saeed97/balancebelt/images/otherdata/schematics.jpg

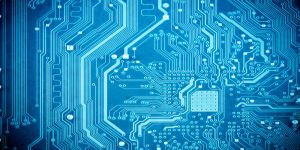
images/otherdata/schematics.jpg
