saeed97/balancebelt/images/about/about.png

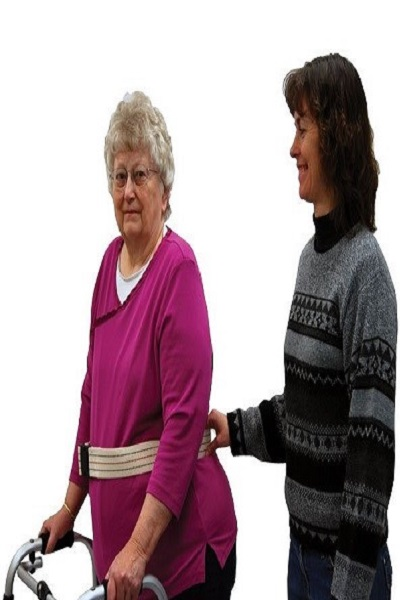
images/about/about.png
