saeed97/balancebelt/images/otherdata/data.jpg

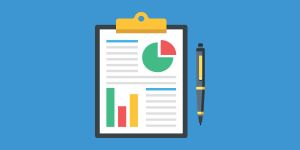
images/otherdata/data.jpg
