saeed97/balancebelt/images/otherdata/datasheets.jpg

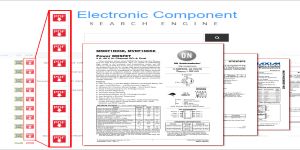
images/otherdata/datasheets.jpg
