saeed97/balancebelt/images/otherdata/sourcecode.jpg

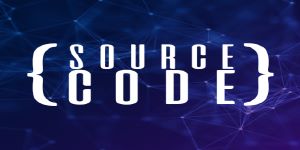
images/otherdata/sourcecode.jpg
