saeed97/balancebelt/OtherData/Schematics/Belt.png

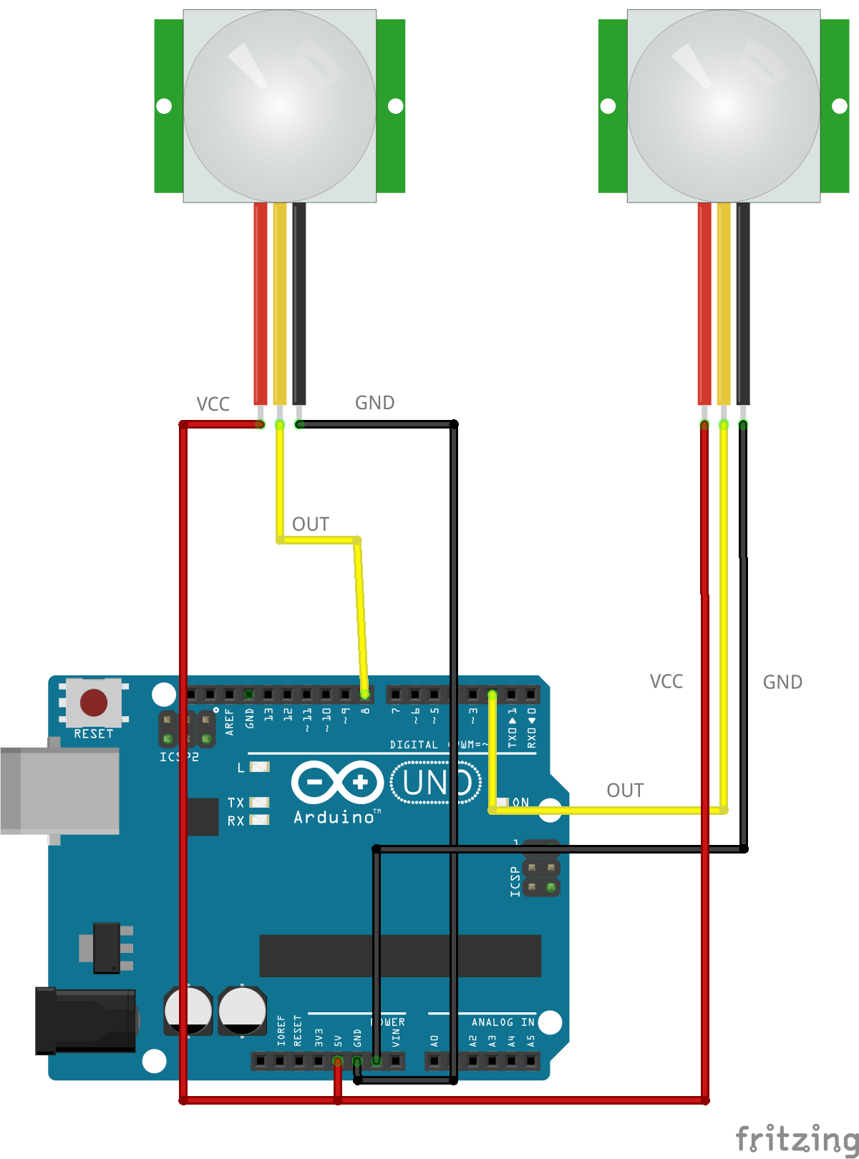
OtherData/Schematics/Belt.png
