saeed97/balancebelt/OtherData/Schematics/Right_Ankle_Bracelet.png

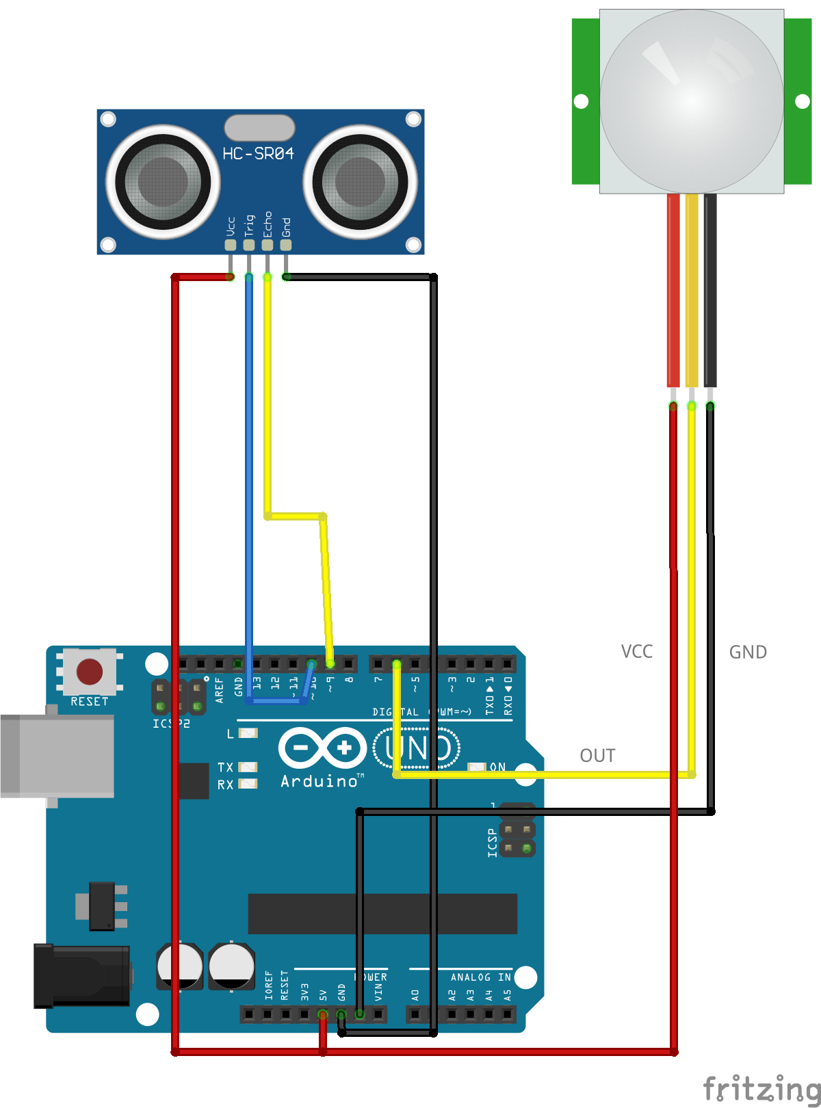
OtherData/Schematics/Right_Ankle_Bracelet.png
