saeed97/balancebelt/Photos/Chris.jpg

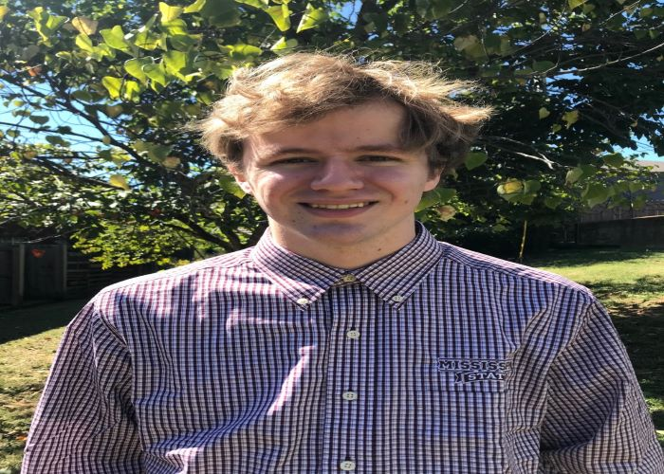
Photos/Chris.jpg
