saeed97/balancebelt/Photos/fowler.jpg

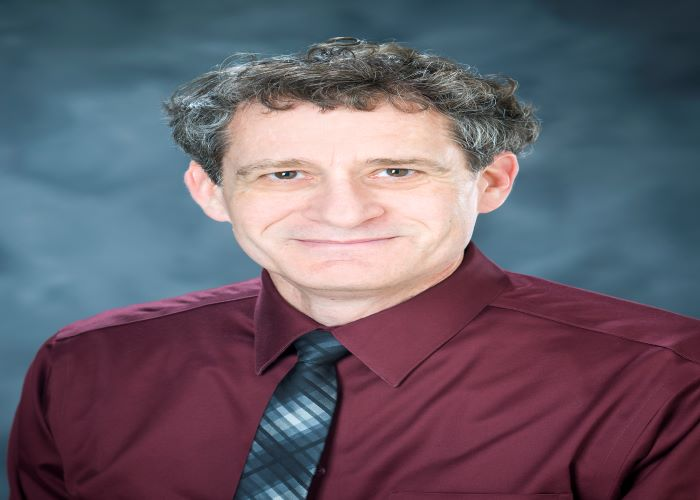
Photos/fowler.jpg
