saeed97/balancebelt/Photos/holiday.jpg

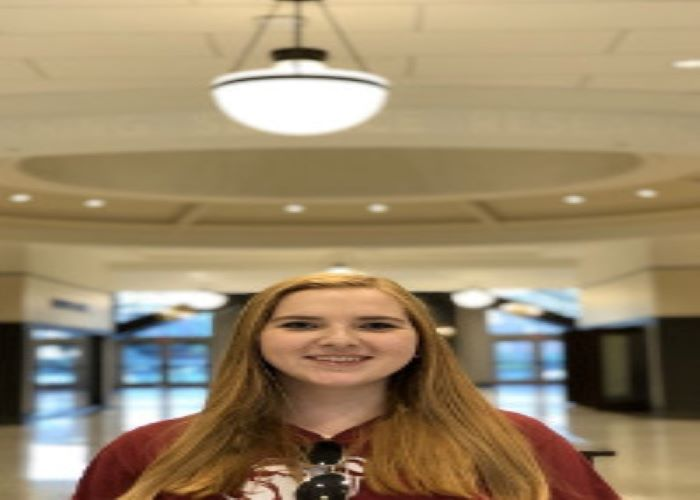
Photos/holiday.jpg
