saeed97/balancebelt/Photos/Moe.jpg

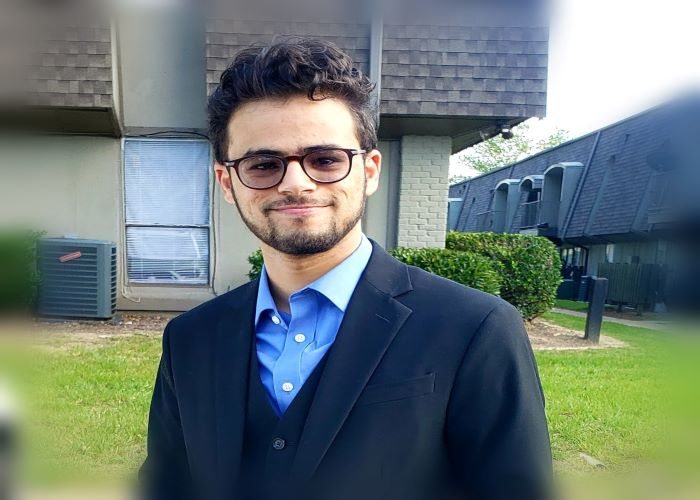
Photos/Moe.jpg
