saeed97/balancebelt/Photos/Ryan.jpg

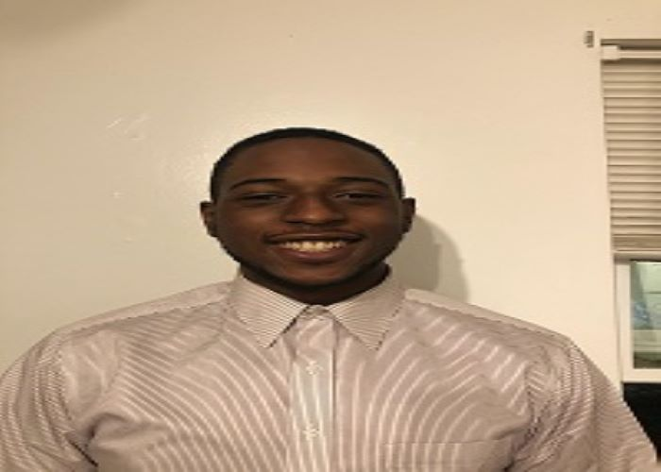
Photos/Ryan.jpg
