saeed97/balancebelt/Photos/Zoe.jpg

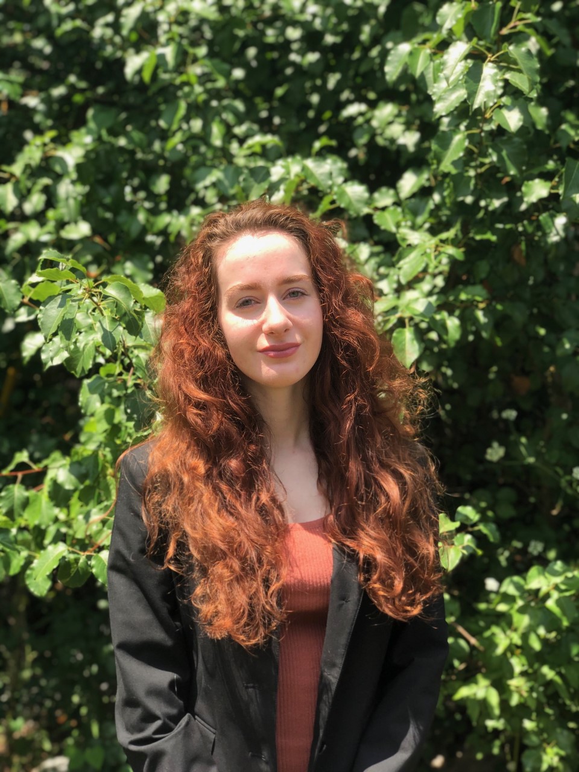
Photos/Zoe.jpg
