saeed97/balancebelt/OtherData/Data/Battery_Test_Data.xlsx

Time (min) | Voltage (V) | Current (mA)
0 | 5.021 | 60
6 | 5.02 | 60
12 | 5.021 | 60
18 | 5.023 | 63
24 | 5.018 | 63
30 | 5.021 | 64
36 | 5.022 | 64
42 | 5.021 | 64
48 | 5.022 | 79
54 | 5.021 | 64
60 | 5.021 | 69
