saeed97/balancebelt/OtherData/Data/Belt_Subsystem_Test.xlsx

Type of Test | Actual Number of Arm Swings | Actual Total Time (sec) | Measured Number of Arm Swings | Measured Total Time (sec) | Percent Error for Time Per Arm Swing | Percent Error for Number of Arm Swings | Pass/Fail
Right Arm | 5 | 9.340 | 5 | 9.359 | 0.203% | 0.00% | Pass
 | 10 | 12.480 | 10 | 12.592 | 0.897% | 0.00% | Pass
 | 15 | 19.590 | 15 | 20.303 | 3.64% | 0.00% | Pass
Left Arm | 5 | 5.970 | 5 | 6.178 | 3.48% | 0.00% | Pass
 | 10 | 12.260 | 10 | 12.841 | 4.74% | 0.00% | Pass
 | 15 | 18.960 | 15 | 19.470 | 2.69% | 0.00% | Pass
Right, Left Arms | 5, 5 | 11.050, 9.870 | 5, 5 | 11.527, 10.198 | 4.32%, 3.32% | 0.00%, 0.00% | Pass
 | 10, 10 | 23.460, 25.90 | 10, 10 | 24.236, 26.227 | 3.31%, 1.26% | 0.00%, 0.00% | Pass
 | 15, 15 | 39.910, 39.300 | 15, 15 | 41.574, 40.073 | 4.17%, 1.97% | 0.00%, 0.00% | Pass
