saeed97/balancebelt/OtherData/Data/LED_Protocol_Tests.xlsx

LED Type | Color | Protocol | Behavior | Satisfactory
Technical | Red | Low battery | Blink twice every two seconds | N/A
Technical | Red | Full memory | Blink five times every two seconds | Yes
Technical | Red | Sensors inoperable | Blink slowly continuously | Yes
Operational | Green | Sensors recording | On continuously | Yes
Operational | Green | Sensors not recording | Off continuously | Yes
Operational | Green | Uploading data | Blink LED quickly | Yes
Operational | Green | USB connected | Blink LED slowly | Yes
Priority of LED Protocol
Protocol | LED Type | Priority
Low battery | Technical | 1
Full memory | Technical | 2
Sensors inoperable | Technical | 3
Uploading data | Operational | 1
USB connected | Operational | 2
Sensors not recording | Operational | 3
Sensors recording | Operational | 4
