saeed97/balancebelt/OtherData/Data/Left_Ankle_Subsystem_Tests.xlsx

Inner PIR Sensor
Actual Step Speed (Steps/Minute) | Measured Step Speed (Steps/Minute) | Percent Error | Pass/Fail
50 | 52.48 | 4.96% | Pass
60 | 60.63 | 1.06% | Pass
75 | 72.20 | 3.74% | Pass
80 | 63.06 | 21.18% | Fail
85 | 71.21 | 16.22% | Fail
Outer PIR Sensor
Object | Range (cm) | Flag Raised (Yes/No) | Pass/Fail
Person | 1 | Yes | Pass
 | 10 | Yes | Pass
 | 50 | Yes | Pass
 | 100 | Yes | Pass
Cat | 1 | Yes | Pass
 | 10 | Yes | Pass
 | 50 | Yes | Pass
 | 100 | Yes | Pass
Car | 30 | Yes | Pass
 | 60 | Yes | Pass
 | 100 | Yes | Pass
 | 200 | Yes | Pass
