saeed97/balancebelt/OtherData/Data/PIR_Tests.xlsx

Test Type | Angle from Normal Direction of Sensor (°) | Requirements | Distance from Sensor (cm) | Results (pirStat) | Pass/Fail
Sunlight/ Clothing | 0, 60 | Must be able to detect clothing in direct sunlight (pirStat ==1) | 1 | 1, 1 | Pass
 |  |  | 10 | 1, 1 | Pass
 |  |  | 50 | 1, 1 | Pass
 |  |  | 100 | 1, 1 | Pass
 |  |  | 500 | 0, 0 | Fail
Sunlight/ Bare Skin | 0, 60 | Must be able to detect bare skin in direct sunlight (pirStat ==1) | 1 | 1, 1 | Pass
 |  |  | 10 | 1, 1 | Pass
 |  |  | 50 | 1, 1 | Pass
 |  |  | 100 | 1, 1 | Pass
 |  |  | 500 | 0, 0 | Fail
Indoors/ Clothing | 0, 60 | Must be able to detect clothing indoors (pirStat ==1) | 1 | 1, 1 | Pass
 |  |  | 10 | 1, 1 | Pass
 |  |  | 50 | 1, 1 | Pass
 |  |  | 100 | 1, 0 | Pass, Fail
 |  |  | 500 | 0, 0 | Fail
Indoors/Bare Skin | 0, 60 | Must be able to detect bare skin indoors (pirStat ==1) | 1 | 1, 1 | Pass
 |  |  | 10 | 1, 1 | Pass
 |  |  | 50 | 1, 1 | Pass
 |  |  | 100 | 1, 0 | Pass, Fail
 |  |  | 500 | 0, 0 | Fail
